engstad/BetsyBoard/README.md

# Experimental STM32L486 breakout board

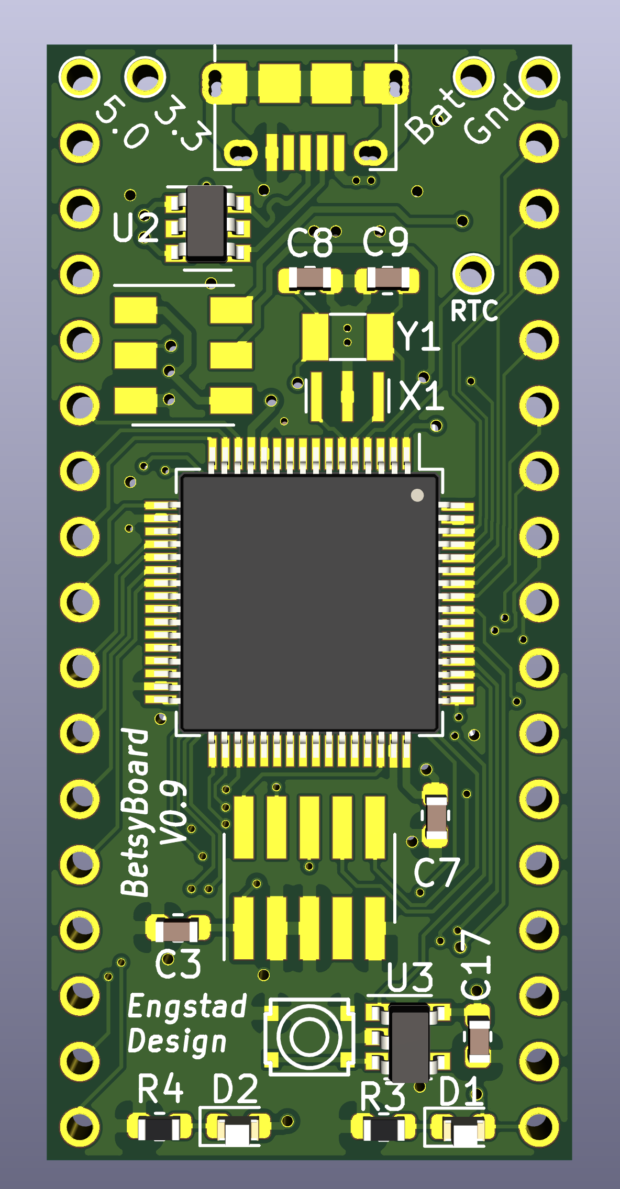
[picture p1: BetsyBoard-Front.png]
alt_tag Front of BetsyBoard

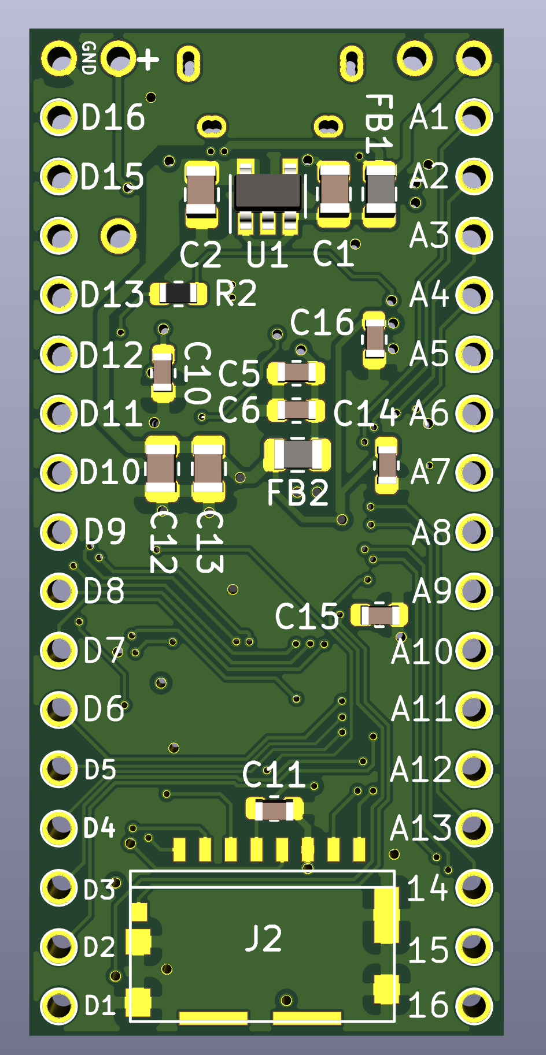
[picture p2: BetsyBoard-Back.png]
alt_tag Back of BetsyBoard
