engstad/BetsyBoard/stm32f.org

* Have about 64 pins

* 3 banks of PA, PB and PC pins (plus a single PD2), is 3*16+1 = 49 pins
* 4 pins for JTAG/DW port: PA{13,14,15}, PB3.
* SDMCC1 port: 8 pins, PC{6,7,8,9,10,11,12}.

So, 49 - 4 - 8 = 49-12 = 37. 

Teensy has 24 on top, and 17 on bottom (24+17 = 41).

So, should be in the ball-park!

FT: 5V tolerant
TT: 3V3 tolerant
_f: Fm+ capable
_l: LCD function supplied with VLCD 
_u: USB function supplied with VUSB
_a: Analog function supplied with VDDA
_s: I/O supplied only by VDDIO2  [NA]

|----+----------------+----+--------+--------+-------------------------------------------------------------------------------------------------------------------------------------------+---------------------------------------|
|  1 | VBAT           | S  |        |        |                                                                                                                                           |                                       |
|  2 | PC13           | IO | FT     | (1)(2) | EO                                                                                                                                        | RTC_TAMP1/RTC_TS/RTC_OUT/WKUP2        |
|  3 | PC14/OSC32_IN  | IO | FT     | (1)(2) | EO                                                                                                                                        | OSC32_IN                              |
|  4 | PC15/OSC32_OUT | IO | FT     | (1)(2) | EO                                                                                                                                        | OSC32_OUT                             |
|  5 | PH0/OSC_IN     | IO | FT     |        | EO                                                                                                                                        | OSC_IN                                |
|  6 | PH1/OSC_OUT    | IO | FT     |        | EO                                                                                                                                        | OSC_OUT                               |
|  7 | NRST           | IO | RST    |        |                                                                                                                                           |                                       |
|  8 | PC0            | IO | FT_fla |        | LPTIM1_IN1/I2C3_SCL/DFSDM_DATIN4/LPUART1_RX/LCD_SEG18/LPTIM2_IN1/EO                                                                       | ADC123_IN1                            |
|  9 | PC1            | IO | FT_fla |        | LPTIM1_OUT/I2C3_SDA/DFSDM_CKIN4/LPUART1_TX/LCD_SEG19/EO                                                                                   | ADC123_IN2                            |
| 10 | PC2            | IO | FT_la  |        | LPTIM1_IN2/SPI2_MISO/DFSDM_CKOUT/LCD_SEG20/EO                                                                                             | ADC123_IN3                            |
| 11 | PC3            | IO | FT_a   |        | LPTIM1_ETR/SPI2_MOSI/LCD_VLCD/SAI1_SD_A/LPTIM2_ETR/EO                                                                                     | ADC123_IN4                            |
| 12 | VSSA/VREF-     | S  |        |        |                                                                                                                                           | VREFBUF_OUT                           |
| 13 | VDDA           | S  |        |        |                                                                                                                                           |                                       |
| 14 | PA0            | IO | FT_a   |        | TIM2_CH1/TIM5_CH1/TIM8_ETR/USART2_CTS/UART4_TX/SAI1_EXTCLK/TIM2_ETR/EO                                                                    | OPAMP1_VINP/ADC12_IN5/RTC_TAMP2/WKUP1 |
| 15 | PA1            | IO | FT_la  |        | TIM2_CH2/TIM5_CH2/USART2_RTS_DE/UART4_RX/LCD_SEG0/TIM15_CH1N/EO                                                                           | OPAMP1_VINM/ADC12_IN6                 |
| 16 | PA2            | IO | FT_la  |        | TIM2_CH3/TIM5_CH3/USART2_TX/LCD_SEG1/SAI2_EXTCLK/TIM15_CH1/EO                                                                             | ADC12_IN7/WKUP4/LSCO                  |
|----+----------------+----+--------+--------+-------------------------------------------------------------------------------------------------------------------------------------------+---------------------------------------|
| 17 | PA3            | IO | TT     | (3)    | TIM2_CH4/TIM5_CH4/USART2_RX/LCD_SEG2/TIM15_CH2/EO                                                                                         | OPAMP1_VOUT/ADC12_IN8                 |
| 18 | VSS            | S  |        |        |                                                                                                                                           |                                       |
| 19 | VDD            | S  |        |        |                                                                                                                                           |                                       |
| 20 | PA4            | IO | TT_a   | (3)    | SPI1_NSS/SPI3_NSS/USART2_CK/SAI1_FS_B/LPTIM2_OUT/EO                                                                                       | ADC12_IN9/DAC1_OUT1                   |
| 21 | PA5            | IO | TT_a   | (3)    | TIM2_CH1/TIM2_ETR/TIM8_CH1N/SPI1_SCK/LPTIM2_ETR/EO                                                                                        | ADC12_IN10/DAC1_OUT2                  |
| 22 | PA6            | IO | FT_la  |        | TIM1_BKIN/TIM3_CH1/TIM8_BKIN/SPI1_MISO/USART3_CTS/QUADSPI_BK1_IO3/LCD_SEG3/TIM1_BKIN_COMP2/TIM8_BKIN_COMP2/TIM16_CH1/EO                   | OPAMP2_VINP/ADC12_IN11                |
| 23 | PA7            | IO | FT_la  |        | TIM1_CH1N/TIM3_CH2/TIM8_CH1N/SPI1_MOSI/QUADSPI_BK1_IO2/LCD_SEG4/TIM17_CH1/EO                                                              | OPAMP2_VINM/ADC12_IN12                |
| 24 | PC4            | IO | FT_la  |        | USART3_TX/LCD_SEG22/EO                                                                                                                    | COMP1_INM/ADC12_IN13                  |
| 25 | PC5            | IO | FT_la  |        | USART3_RX/LCD_SEG23/EO                                                                                                                    | COMP1_INP/ADC12_IN14/WKUP5            |
| 26 | PB0            | IO | TT_la  | (3)    | TIM1_CH2N/TIM3_CH3/TIM8_CH2N/USART3_CK/QUADSPI_BK1_IO1/LCD_SEG5/COMP1_OUT/EO                                                              | OPAMP2_VOUT/ADC12_IN15                |
| 27 | PB1            | IO | FT_la  |        | TIM1_CH3N/TIM3_CH4/TIM8_CH3N/DFSDM_DATIN0/USART3_RTS_DE/QUADSPI_BK1_IO0/LCD_SEG6/LPTIM2_IN1/EO                                            | COMP1_INM/ADC12_IN16                  |
| 28 | PB2            | IO | FT_a   |        | RTC_OUT/LPTIM1_OUT/I2C3_SMBA/DFSDM_CKIN0/EO                                                                                               | COMP1_INP                             |
| 29 | PB10           | IO | FT_fl  |        | TIM2_CH3/I2C2_SCL/SPI2_SCK/DFSDM_DATIN7/USART3_TX/LPUART1_RX/QUADSPI_CLK/LCD_SEG10/COMP1_OUT/SAI1_SCK_A/EO                                |                                       |
| 30 | PB11           | IO | FT_fl  |        | TIM2_CH4/I2C2_SDA/DFSDM_CKIN7/USART3_RX/LPUART1_TX/QUADSPI_NCS/LCD_SEG11/COMP2_OUT/EO                                                     |                                       |
| 31 | VSS            | S  |        |        |                                                                                                                                           |                                       |
| 32 | VDD            | S  |        |        |                                                                                                                                           |                                       |
|----+----------------+----+--------+--------+-------------------------------------------------------------------------------------------------------------------------------------------+---------------------------------------|
| 33 | PB12           | IO | FT_l   |        | TIM1_BKIN/TIM1_BKIN_COMP2/I2C2_SMBA/SPI2_NSS/DFSDM_DATIN1/USART3_CK/LPUART1_RTS_DE/TSC_G1_IO1/LCD_SEG12/SWPMI1_IO/SAI2_FS_A/TIM15_BKIN/EO |                                       |
| 34 | PB13           | IO | FT_fl  |        | TIM1_CH1N/I2C2_SCL/SPI2_SCK/DFSDM_CKIN1/USART3_CTS/LPUART1_CTS/TSC_G1_IO2/LCD_SEG13/SWPMI1_TX/SAI2_SCK_A/TIM15_CH1N/EO                    |                                       |
| 35 | PB14           | IO | FT_fl  |        | TIM1_CH2N/TIM8_CH2N/I2C2_SDA/SPI2_MISO/DFSDM_DATIN2/USART3_RTS_DE/TSC_G1_IO3/LCD_SEG14/SWPMI1_RX/SAI2_MCLK_A/TIM15_CH1/EO                 |                                       |
| 36 | PB15           | IO | FT_l   |        | RTC_REFIN/TIM1_CH3N/TIM8_CH3N/SPI2_MOSI/DFSDM_CKIN2/TSC_G1_IO4/LCD_SEG15/SWPMI1_SUSPEND/SAI2_SD_A/TIM15_CH2/EO                            |                                       |
| 37 | PC6            | IO | FT_l   |        | TIM3_CH1/TIM8_CH1/DFSDM_CKIN3/TSC_G4_IO1/LCD_SEG24/SDMMC1_D6/SAI2_MCLK_A/EO                                                               |                                       |
| 38 | PC7            | IO | FT_l   |        | TIM3_CH2/TIM8_CH2/DFSDM_DATIN3/TSC_G4_IO2/LCD_SEG25/SDMMC1_D7/SAI2_MCLK_B/EO                                                              |                                       |
| 39 | PC8            | IO | FT_l   |        | TIM3_CH3/TIM8_CH3/TSC_G4_IO3/LCD_SEG26/SDMMC1_D0/EO                                                                                       |                                       |
| 40 | PC9            | IO | FT_l   |        | TIM8_BKIN2/TIM3_CH4/TIM8_CH4/TSC_G4_IO4/OTG_FS_NOE/LCD_SEG27/SDMMC1_D1/SAI2_EXTCLK/TIM8_BKIN2_COMP1/EO                                    |                                       |
| 41 | PA8            | IO | FT_l   |        | MCO/TIM1_CH1/USART1_CK/OTG_FS_SOF/LCD_COM0/LPTIM2_OUT/EO                                                                                  |                                       |
| 42 | PA9            | IO | FT_lu  |        | TIM1_CH2/USART1_TX/LCD_COM1/TIM15_BKIN/EO                                                                                                 | OTG_FS_VBUS                           |
| 43 | PA10           | IO | FT_lu  |        | TIM1_CH3/USART1_RX/OTG_FS_ID/LCD_COM2/TIM17_BKIN/EO                                                                                       |                                       |
| 44 | PA11           | IO | FT_u   |        | TIM1_CH4/TIM1_BKIN2/USART1_CTS/CAN1_RX/OTG_FS_DM/TIM1_BKIN2_COMP1/EO                                                                      |                                       |
| 45 | PA12           | IO | FT_u   |        | TIM1_ETR/USART1_RTS_DE/CAN1_TX/OTG_FS_DP/EVENTOUT                                                                                         |                                       |
| 46 | PA13           | IO | FT     | (4)    | JTMS/SWDAT/IR_OUT/OTG_FS_NOE/EVENTOUT                                                                                                     |                                       |
| 47 | VSS            | S  |        |        |                                                                                                                                           |                                       |
| 48 | VDDUSB         | S  |        |        |                                                                                                                                           |                                       |
|----+----------------+----+--------+--------+-------------------------------------------------------------------------------------------------------------------------------------------+---------------------------------------|
| 49 | PA14           | IO | FT     | (4)    | JTCK/SWCLK/EVENTOUT                                                                                                                       |                                       |
| 50 | PA15           | IO | FT_l   | (4)    | JTDI/TIM2_CH1/TIM2_ETR/SPI1_NSS/SPI3_NSS/UART4_RTS_DE/TSC_G3_IO1/LCD_SEG17/SAI2_FS_B/EVENTOUT                                             |                                       |
| 51 | PC10           | IO | FT_l   |        | SPI3_SCK/USART3_TX/UART4_TX/TSC_G3_IO2/LCD_COM4/LCD_SEG28/LCD_SEG40/SDMMC1_D2/SAI2_SCK_B/EVENTOUT                                         |                                       |
| 52 | PC11           | IO | FT_l   |        | SPI3_MISO/USART3_RX/UART4_RX/TSC_G3_IO3/LCD_COM5/LCD_SEG29/LCD_SEG41/SDMMC1_D3/SAI2_MCLK_B/EVENTOUT                                       |                                       |
| 53 | PC12           | IO | FT_l   |        | SPI3_MOSI/USART3_CK/UART5_TX/TSC_G3_IO4/LCD_COM6/LCD_SEG30/LCD_SEG42/SDMMC1_CK/SAI2_SD_B/EVENTOUT                                         |                                       |
| 54 | PD2            | IO | FT_l   |        | TIM3_ETR/USART3_RTS_DE/UART5_RX/TSC_SYNC/LCD_COM7/LCD_SEG31/LCD_SEG43/SDMMC1_CMD/EVENTOUT                                                 |                                       |
| 55 | PB3            | IO | FT_la  | (4)    | JTDO/TRACESWO/TIM2_CH2/SPI1_SCK/SPI3_SCK/USART1_RTS_DE/LCD_SEG7/SAI1_SCK_B/EVENTOUT                                                       | COMP2_INM                             |
| 56 | PB4            | IO | FT_la  | (4)    | NJTRST/TIM3_CH1/SPI1_MISO/SPI3_MISO/USART1_CTS/UART5_RTS_DE/TSC_G2_IO1/LCD_SEG8/SAI1_MCLK_B/TIM17_BKIN/EVENTOUT                           | COMP2_INP                             |
| 57 | PB5            | IO | FT_la  |        | LPTIM1_IN1/TIM3_CH2/I2C1_SMBA/SPI1_MOSI/SPI3_MOSI/USART1_CK/UART5_CTS/TSC_G2_IO2/LCD_SEG9/COMP2_OUT/SAI1_SD_B/TIM16_BKIN/EVENTOUT         |                                       |
| 58 | PB6            | IO | FT_fa  |        | LPTIM1_ETR/TIM4_CH1/TIM8_BKIN2/I2C1_SCL/DFSDM_DATIN5/USART1_TX/TSC_G2_IO3/TIM8_BKIN2_COMP2/SAI1_FS_B/TIM16_CH1N/EVENTOUT                  | COMP2_INP                             |
| 59 | PB7            | IO | FT_fla |        | LPTIM1_IN2/TIM4_CH2/TIM8_BKIN/I2C1_SDA/DFSDM_CKIN5/USART1_RX/UART4_CTS/TSC_G2_IO4/LCD_SEG21/FMC_NL/TIM8_BKIN_COMP1/TIM17_CH1N/EVENTOUT    | COMP2_INM/PVD_IN                      |
| 60 | BOOT0          | B  |        |        |                                                                                                                                           |                                       |
| 61 | PB8            | IO | FT_fl  |        | TIM4_CH3/I2C1_SCL/DFSDM_DATIN6/CAN1_RX/LCD_SEG16/SDMMC1_D4/SAI1_MCLK_A/TIM16_CH1/EVENTOUT                                                 |                                       |
| 62 | PB9            | IO | FT_fl  |        | IR_OUT/TIM4_CH4/I2C1_SDA/SPI2_NSS/DFSDM_CKIN6/CAN1_TX/LCD_COM3/SDMMC1_D5/SAI1_FS_A/TIM17_CH1/EVENTOUT                                     |                                       |
| 63 | VSS            | S  |        |        |                                                                                                                                           |                                       |
| 64 | VDD            | S  |        |        |                                                                                                                                           |                                       |
|----+----------------+----+--------+--------+-------------------------------------------------------------------------------------------------------------------------------------------+---------------------------------------|

(1): Supplied through power switch [GPIO is limited]
(2): 
(3): Reduced touch sensing sensitivity
(4): JTAG ready after reset (PA15,PA13,PB4 pulled up, PA14 pulled down)
