engstad/BetsyBoard/BetsyBoardBig-schematic.pdf

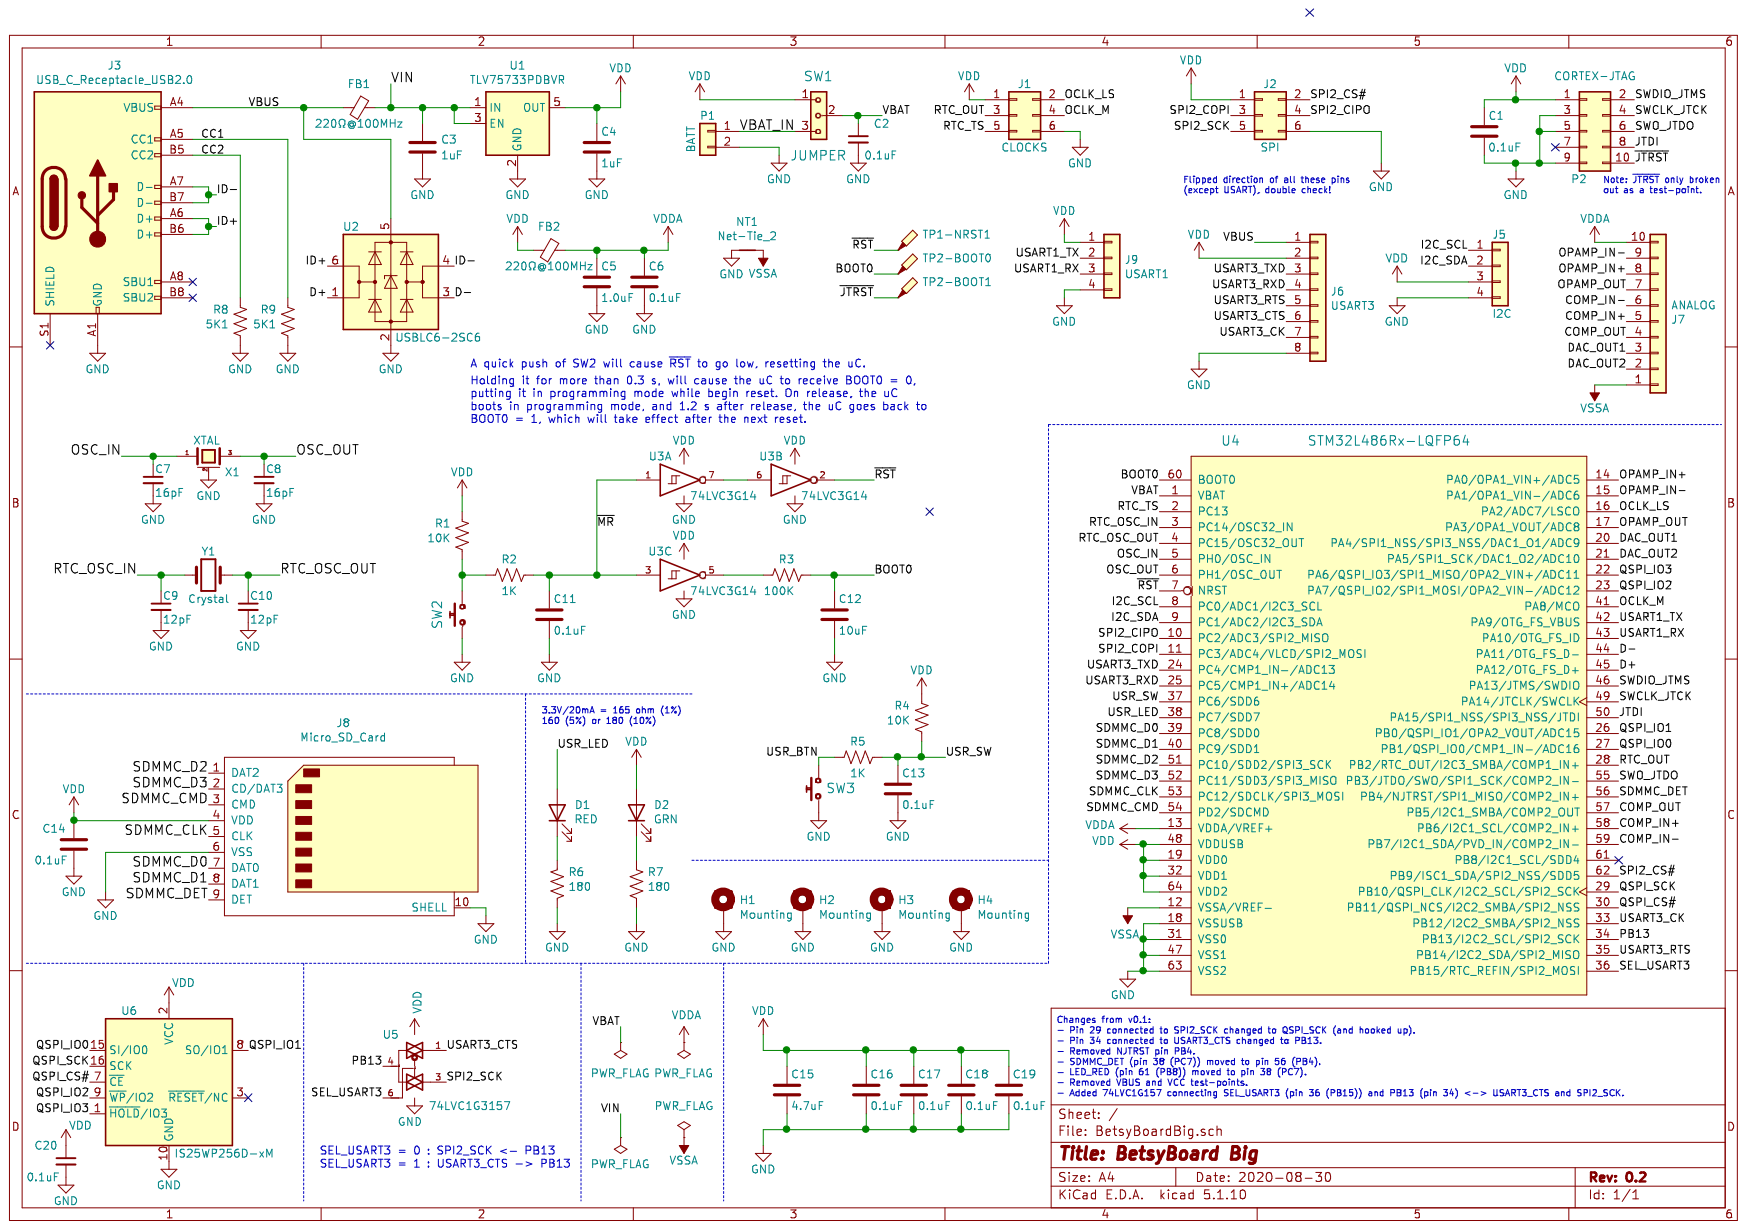
[picture p3: page 1]
