engstad/BetsyBoard/BetsyBoard-Front.pdf

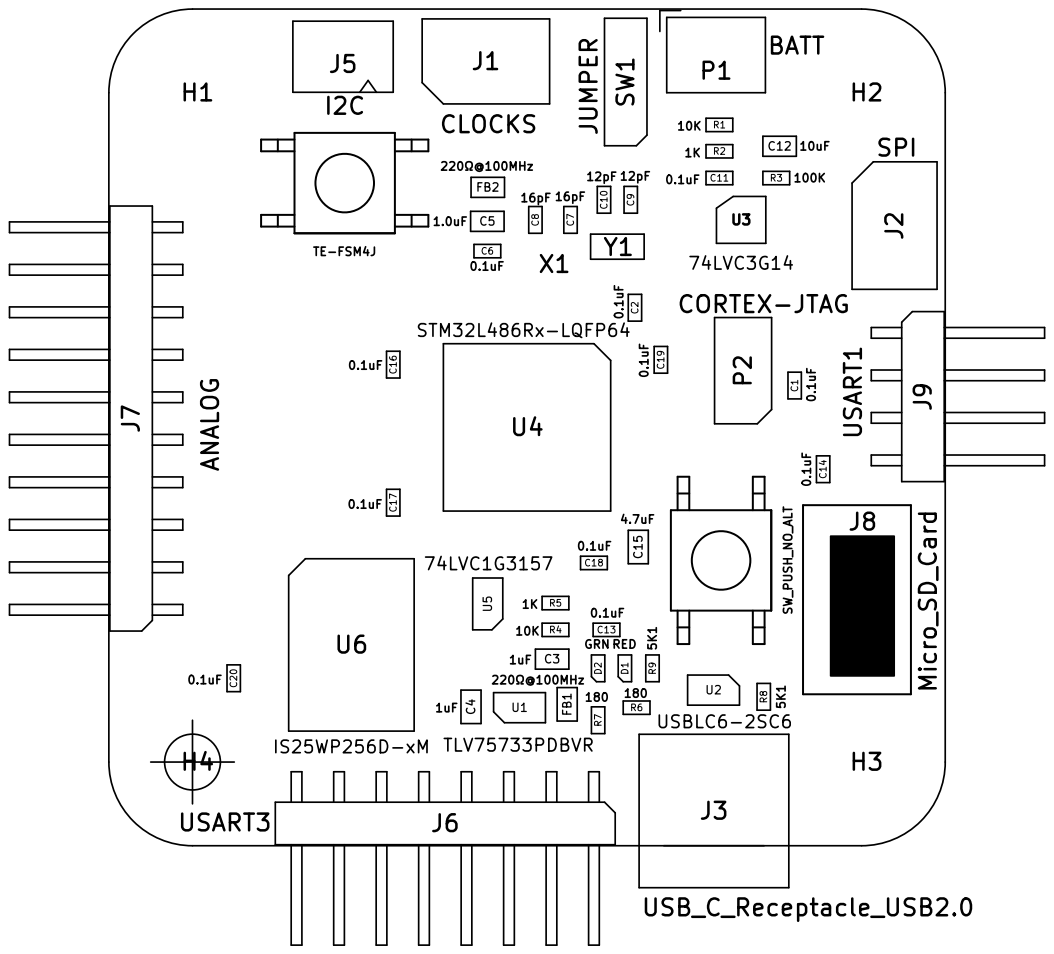
[picture p4: page 1]
