engstad/BetsyBoard/BetsyBoardBig.kicad_pcb

## KiCad design BetsyBoardBig.kicad_pcb (2024-01-12)

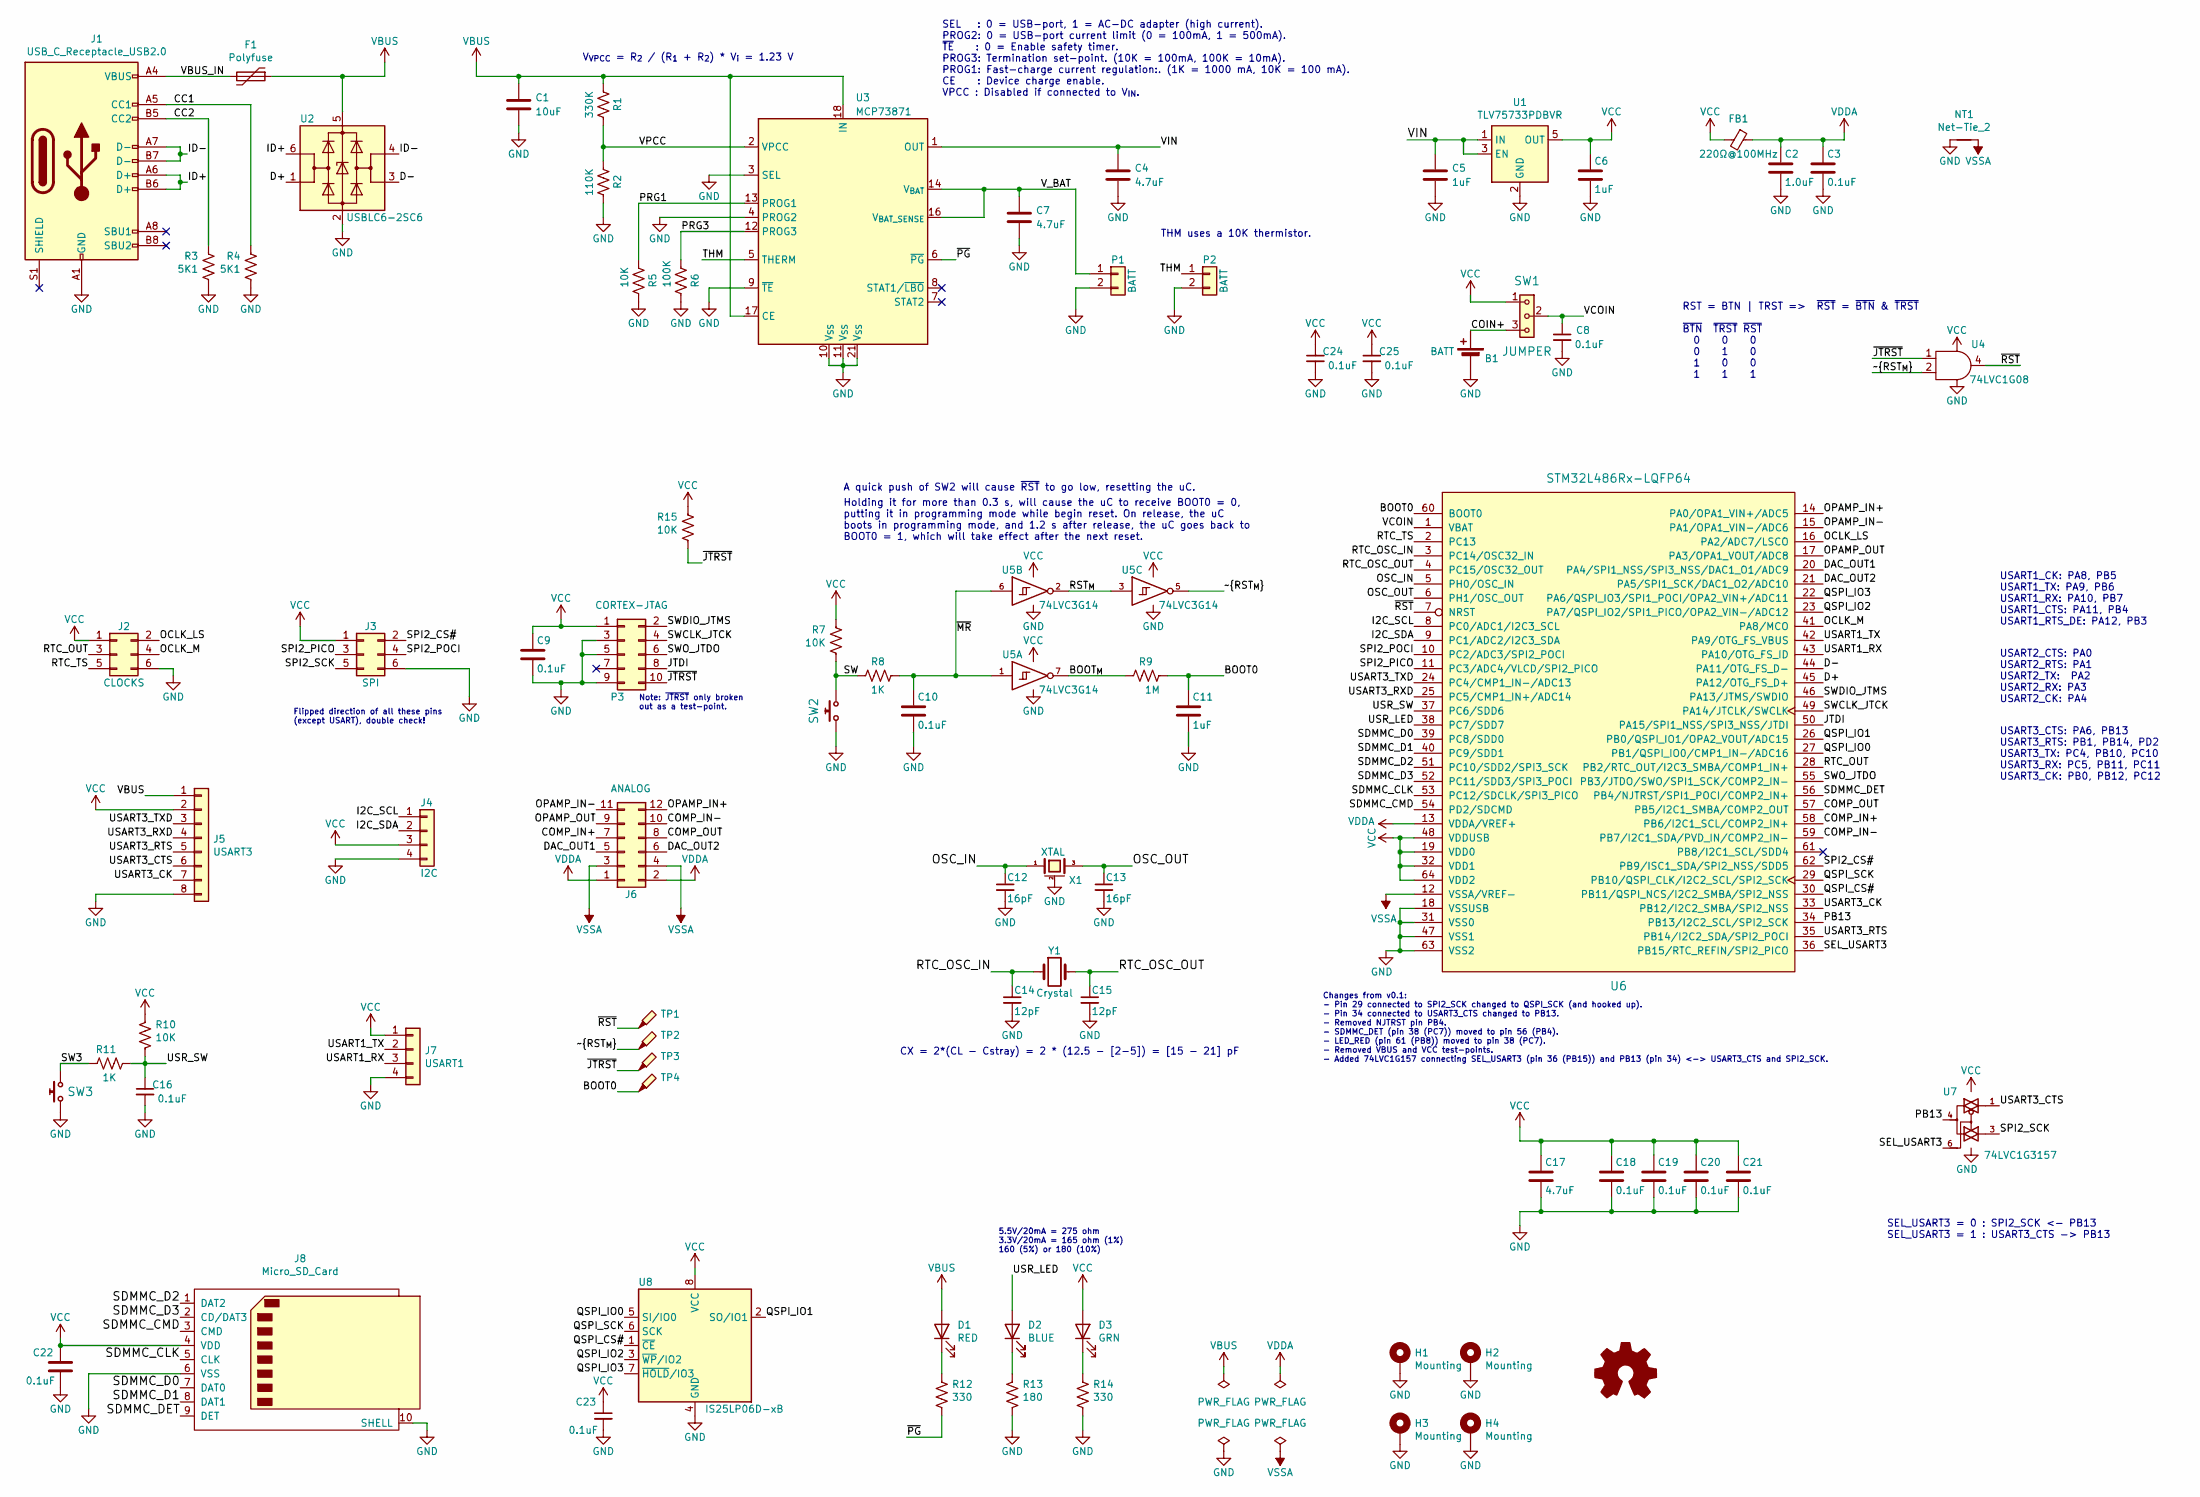
[picture p5: schematic BetsyBoardBig.kicad_sch, BetsyBoard Big]

Parts:
B1: BATT; Battery_Keystone_2894
C1: 10uF; C_0805_2012Metric
C2: 1.0uF; C_0805_2012Metric
C3, C8, C9, C10, C16, C18, C19, C20, C21, C22, C23, C24, C25: 0.1uF; C_0603_1608Metric
C4, C7, C17: 4.7uF; C_0805_2012Metric
C5, C6: 1uF; C_0805_2012Metric
C11: 1uF; C_0603_1608Metric
C12, C13: 16pF; C_0603_1608Metric
C14, C15: 12pF; C_0603_1608Metric
D1: RED; LED_0603_1608Metric
D2: BLUE; LED_0603_1608Metric
D3: GRN; LED_0603_1608Metric
F1: Polyfuse; Fuse_0805_2012Metric
FB1: 220Ω@100MHz; L_0805_2012Metric; Manuf # BLM21PG221SN1D
H1, H2, H3, H4: Mounting; MountingHole_3.2mm_M3_Pad_Via
J1: USB_C_Receptacle_USB2.0; USB_C_Receptacle_GCT_USB4085
J2: CLOCKS; PinHeader_2x03_P2.54mm_Vertical
J3: SPI; PinHeader_2x03_P2.54mm_Vertical
J4: I2C; JST_SH_SM04B-SRSS-TB_1x04-1MP_P1.00mm_Horizontal
J5: USART3; PinHeader_1x08_P2.54mm_Horizontal
J6: ANALOG; PinHeader_2x06_P2.54mm_Horizontal
J7: USART1; PinHeader_1x04_P2.54mm_Horizontal
J8: Micro_SD_Card; Molex_PS_105162_001; DigiKey# WM14405CT-ND
NT1: Net-Tie_2; NetTie-2_SMD_Pad0.5mm
P1: BATT; JST_PH_B2B-PH-K_1x02_P2.00mm_Vertical
P2: BATT; pin-socket-2
P3: CORTEX-JTAG; PinHeader_2x05_P1.27mm_Vertical
R1: 330K; R_0603_1608Metric
R2: 110K; R_0603_1608Metric
R3, R4: 5K1; R_0603_1608Metric
R5, R7, R10, R15: 10K; R_0603_1608Metric
R6: 100K; R_0603_1608Metric
R8, R11: 1K; R_0603_1608Metric
R9: 1M; R_0603_1608Metric
R12, R14: 330; R_0603_1608Metric
R13: 180; R_0603_1608Metric
SW1: JUMPER; PinHeader_1x03_P2.54mm_Vertical
SW2: TE-FSM4J; TACTILE_SWITCH-TE-FSM4JSMAATR
SW3: SW_PUSH_NO_ALT; TACTILE_SWITCH-TE-FSM4JSMAATR
TP1, TP2, TP3, TP4: TestPoint_Probe; TestPoint_Pad_1.0x1.0mm
U1: TLV75733PDBVR‎; SOT-23-5
U2: USBLC6-2SC6; SOT-23-6
U3: MCP73871; QFN-20-1EP_4x4mm_P0.5mm_EP2.5x2.5mm
U4: 74LVC1G08; SOT-23-5
U5: 74LVC3G14; SSOP-8_2.95x2.8mm_P0.65mm
U6: STM32L486Rx-LQFP64; LQFP-64_10x10mm_P0.5mm
U7: 74LVC1G3157; SOT-23-6
U8: IS25LP06D-xB; SOIC-8_5.275x5.275mm_P1.27mm
X1: XTAL; cstce-v-c
Y1: Crystal; Crystal_SMD_3215-2Pin_3.2x1.5mm

Connections:
/BOOT0: C11.1, R9.1, TP4.1, U6.60 (BOOT0)
/BOOT_{M}: R9.2, U5.7
/CC1: J1.A5 (CC1), R4.1
/CC2: J1.B5 (CC2), R3.1
/COIN+: B1.1 (+), SW1.3
/COMP_IN+: J6.7, U6.58 (PB6/I2C1_SCL/COMP2_IN+)
/COMP_IN-: J6.10, U6.59 (PB7/I2C1_SDA/PVD_IN/COMP2_IN-)
/COMP_OUT: J6.8, U6.57 (PB5/I2C1_SMBA/COMP2_OUT)
/D+: U2.1 (I/O1), U6.45 (PA12/OTG_FS_D+)
/D-: U2.3 (I/O2), U6.44 (PA11/OTG_FS_D-)
/DAC_OUT1: J6.5, U6.20 (PA4/SPI1_NSS/SPI3_NSS/DAC1_O1/ADC9)
/DAC_OUT2: J6.6, U6.21 (PA5/SPI1_SCK/DAC1_O2/ADC10)
/I2C_SCL: J4.1, U6.8 (PC0/ADC1/I2C3_SCL)
/I2C_SDA: J4.2, U6.9 (PC1/ADC2/I2C3_SDA)
/ID+: J1.A6 (D+), J1.B6 (D+), U2.6 (I/O1)
/ID-: J1.A7 (D-), J1.B7 (D-), U2.4 (I/O2)
/JTDI: P3.8, U6.50 (PA15/SPI1_NSS/SPI3_NSS/JTDI)
/OCLK_LS: J2.2, U6.16 (PA2/ADC7/LSCO)
/OCLK_M: J2.4, U6.41 (PA8/MCO)
/OPAMP_IN+: J6.12, U6.14 (PA0/OPA1_VIN+/ADC5)
/OPAMP_IN-: J6.11, U6.15 (PA1/OPA1_VIN-/ADC6)
/OPAMP_OUT: J6.9, U6.17 (PA3/OPA1_VOUT/ADC8)
/OSC_IN: C12.1, U6.5 (PH0/OSC_IN), X1.1
/OSC_OUT: C13.1, U6.6 (PH1/OSC_OUT), X1.3
/PB13: U6.34 (PB13/I2C2_SCL/SPI2_SCK), U7.4
/PRG1: R5.2, U3.13 (PROG1)
/PRG3: R6.2, U3.12 (PROG3)
/QSPI_CS#: U6.30 (PB11/QSPI_NCS/I2C2_SMBA/SPI2_NSS), U8.1 (~CE)
/QSPI_IO0: U6.27 (PB1/QSPI_IO0/CMP1_IN-/ADC16), U8.5 (SI/IO0)
/QSPI_IO1: U6.26 (PB0/QSPI_IO1/OPA2_VOUT/ADC15), U8.2 (SO/IO1)
/QSPI_IO2: U6.23 (PA7/QSPI_IO2/SPI1_PICO/OPA2_VIN-/ADC12), U8.3 (~WP/IO2)
/QSPI_IO3: U6.22 (PA6/QSPI_IO3/SPI1_POCI/OPA2_VIN+/ADC11), U8.7 (~HOLD/IO3)
/QSPI_SCK: U6.29 (PB10/QSPI_CLK/I2C2_SCL/SPI2_SCK), U8.6 (SCK)
/RST_{M}: U5.2, U5.3
/RTC_OSC_IN: C14.1, U6.3 (PC14/OSC32_IN), Y1.1
/RTC_OSC_OUT: C15.1, U6.4 (PC15/OSC32_OUT), Y1.2
/RTC_OUT: J2.3, U6.28 (PB2/RTC_OUT/I2C3_SMBA/COMP1_IN+)
/RTC_TS: J2.5, U6.2 (PC13)
/SDMMC_CLK: J8.5 (CLK), U6.53 (PC12/SDCLK/SPI3_PICO)
/SDMMC_CMD: J8.3 (CMD), U6.54 (PD2/SDCMD)
/SDMMC_D0: J8.7 (DAT0), U6.39 (PC8/SDD0)
/SDMMC_D1: J8.8 (DAT1), U6.40 (PC9/SDD1)
/SDMMC_D2: J8.1 (DAT2), U6.51 (PC10/SDD2/SPI3_SCK)
/SDMMC_D3: J8.2 (CD/DAT3), U6.52 (PC11/SDD3/SPI3_POCI)
/SDMMC_DET: J8.9 (DET), U6.56 (PB4/NJTRST/SPI1_POCI/COMP2_IN+)
/SEL_USART3: U6.36 (PB15/RTC_REFIN/SPI2_PICO), U7.6
/SPI2_CS#: J3.2, U6.62 (PB9/ISC1_SDA/SPI2_NSS/SDD5)
/SPI2_PICO: J3.3, U6.11 (PC3/ADC4/VLCD/SPI2_PICO)
/SPI2_POCI: J3.4, U6.10 (PC2/ADC3/SPI2_POCI)
/SPI2_SCK: J3.5, U7.3
/SW: R7.2, R8.2, SW2.2
/SW3: R11.2, SW3.2
/SWCLK_JTCK: P3.4, U6.49 (PA14/JTCLK/SWCLK)
/SWDIO_JTMS: P3.2, U6.46 (PA13/JTMS/SWDIO)
/SWO_JTDO: P3.6, U6.55 (PB3/JTDO/SWO/SPI1_SCK/COMP2_IN-)
/THM: P2.1, U3.5 (THERM)
/USART1_RX: J7.3, U6.43 (PA10/OTG_FS_ID)
/USART1_TX: J7.2, U6.42 (PA9/OTG_FS_VBUS)
/USART3_CK: J5.7, U6.33 (PB12/I2C2_SMBA/SPI2_NSS)
/USART3_CTS: J5.6, U7.1
/USART3_RTS: J5.5, U6.35 (PB14/I2C2_SDA/SPI2_POCI)
/USART3_RXD: J5.4, U6.25 (PC5/CMP1_IN+/ADC14)
/USART3_TXD: J5.3, U6.24 (PC4/CMP1_IN-/ADC13)
/USR_LED: D2.2 (A), U6.38 (PC7/SDD7)
/USR_SW: C16.1, R10.2, R11.1, U6.37 (PC6/SDD6)
/VBUS_IN: F1.2, J1.A4 (VBUS), J1.A9 (VBUS), J1.B4 (VBUS), J1.B9 (VBUS)
/VCOIN: C8.1, SW1.2, U6.1 (VBAT)
/VIN: C4.1, C5.1, U1.1 (IN), U1.3 (EN), U3.1 (OUT), U3.20 (OUT)
/VPCC: R1.1, R2.2, U3.2 (VPCC)
/V_BAT: C7.1, P1.1, U3.14 (V_{BAT}), U3.15 (V_{BAT}), U3.16 (V_{BAT_SENSE})
/~JTRST: P3.10, R15.2, TP3.1, U4.1
/~MR: C10.1, R8.1, U5.1, U5.6
/~PG: R12.2, U3.6 (~PG)
/~RST_{M}: TP2.1, U4.2, U5.5
/~RST: TP1.1, U4.4, U6.7 (NRST)
GND: B1.2 (-), C1.2, C2.2, C3.2, C4.2, C5.2, C6.2, C7.2, C8.2, C9.2, C10.2, C11.2, C12.2, C13.2, C14.2, C15.2, C16.2, C17.2, C18.2, C19.2, C20.2, C21.2, C22.2, C23.2, C24.2, C25.2, H1.1, H2.1, H3.1, H4.1, J1.A1 (GND), J1.A12 (GND), J1.B1 (GND), J1.B12 (GND), J2.6, J3.6, J4.4, J5.8, J7.4, J8.6 (VSS), J8.10 (SHELL), NT1.1, P1.2, P2.2, P3.3, P3.5, P3.9, R2.1, R3.2, R4.2, R5.1, R6.1, R13.2, R14.2, SW2.1, SW3.1, U1.2 (GND), U2.2 (GND), U3.3 (SEL), U3.4 (PROG2), U3.9 (~TE), U3.10 (V_{SS}), U3.11 (V_{SS}), U3.21 (V_{SS}), U4.3 (GND), U5.4 (GND), U6.18 (VSSUSB), U6.31 (VSS0), U6.47 (VSS1), U6.63 (VSS2), U7.2 (GND), U8.4 (GND), X1.2 (gnd)
unnamed: D1.1 (K), R12.1
unnamed: D2.1 (K), R13.1
unnamed: D3.1 (K), R14.1
VBUS: C1.1, D1.2 (A), F1.1, J5.1, R1.2, U2.5 (VBUS), U3.17 (CE), U3.18 (IN), U3.19 (IN)
VCC: C6.1, C9.1, C17.1, C18.1, C19.1, C20.1, C21.1, C22.1, C23.1, C24.1, C25.1, D3.2 (A), FB1.2, J2.1, J3.1, J4.3, J5.2, J7.1, J8.4 (VDD), P3.1, R7.1, R10.1, R15.1, SW1.1, U1.5 (OUT), U4.5 (VCC), U5.8 (VCC), U6.19 (VDD0), U6.32 (VDD1), U6.48 (VDDUSB), U6.64 (VDD2), U7.5 (VCC), U8.8 (VCC)
VDDA: C2.1, C3.1, FB1.1, J6.1, J6.2, U6.13 (VDDA/VREF+)
VSSA: J6.3, J6.4, NT1.2, U6.12 (VSSA/VREF-)

Notes on the sheet:
A quick push of SW2 will cause ~{RST} to go low, resetting the uC.
Note: ~{JTRST} only broken out as a test-point.
RST = BTN | TRST => ~{RST} = ~{BTN} & ~{TRST} ~{BTN} ~{TRST} ~{RST} 0 0 0 0 1 0 1 0 0 1 1 1
USART2_CTS: PA0 USART2_RTS: PA1 USART2_TX: PA2 USART2_RX: PA3 USART2_CK: PA4
Holding it for more than 0.3 s, will cause the uC to receive BOOT0 = 0, putting it in programming mode while begin reset. On release, the uC boots in programming mode, and 1.2 s after release, the uC goes back to BOOT0 = 1, which will take effect after the next reset.
Flipped direction of all these pins (except USART), double check!
THM uses a 10K thermistor.
CX = 2*(CL - Cstray) = 2 * (12.5 - [2-5]) = [15 - 21] pF
V_{VPCC} = R_{2} / (R_{1} + R_{2}) * V_{i} = 1.23 V
USART1_CK: PA8, PB5 USART1_TX: PA9, PB6 USART1_RX: PA10, PB7 USART1_CTS: PA11, PB4 USART1_RTS_DE: PA12, PB3
USART3_CTS: PA6, PB13 USART3_RTS: PB1, PB14, PD2 USART3_TX: PC4, PB10, PC10 USART3_RX: PC5, PB11, PC11 USART3_CK: PB0, PB12, PC12
SEL_USART3 = 0 : SPI2_SCK <- PB13 SEL_USART3 = 1 : USART3_CTS -> PB13
SEL : 0 = USB-port, 1 = AC-DC adapter (high current). PROG2: 0 = USB-port current limit (0 = 100mA, 1 = 500mA). ~{TE} : 0 = Enable safety timer. PROG3: Termination set-point. (10K = 100mA, 100K = 10mA). PROG1: Fast-charge current regulation:. (1K = 1000 mA, 10K = 100 mA). CE : Device charge enable.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
5.5V/20mA = 275 ohm 3.3V/20mA = 165 ohm (1%) 160 (5%) or 180 (10%)
Changes from v0.1: - Pin 29 connected to SPI2_SCK changed to QSPI_SCK (and hooked up). - Pin 34 connected to USART3_CTS changed to PB13. - Removed NJTRST pin PB4. - SDMMC_DET (pin 38 (PC7)) moved to pin 56 (PB4). - LED_RED (pin 61 (PB8)) moved to pin 38 (PC7). - Removed VBUS and VCC test-points. - 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

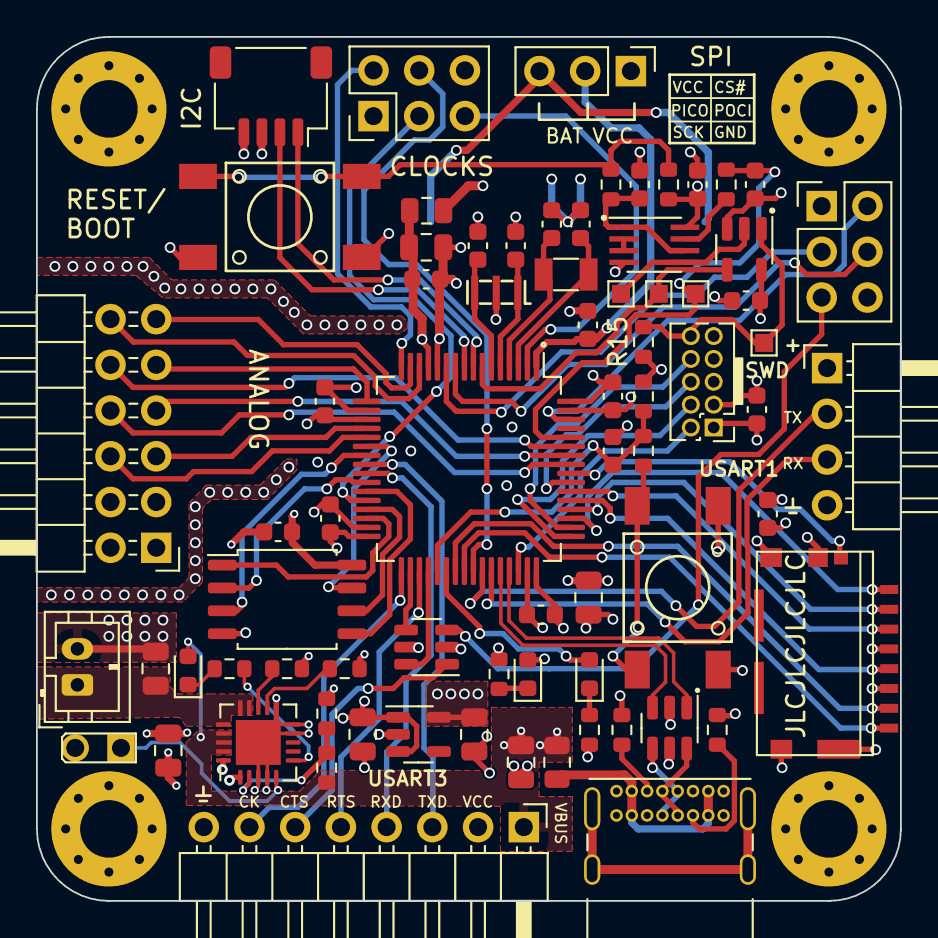
[picture p6: board BetsyBoardBig.kicad_pcb from above]

Board: 4 copper layers, 48.0 x 48.0 mm, 79 parts (1 on the bottom side), 83 nets.
