engstad/BetsyBoard/BetsyBoard.kicad_pcb

## KiCad design BetsyBoard.kicad_pcb (2024-01-05)

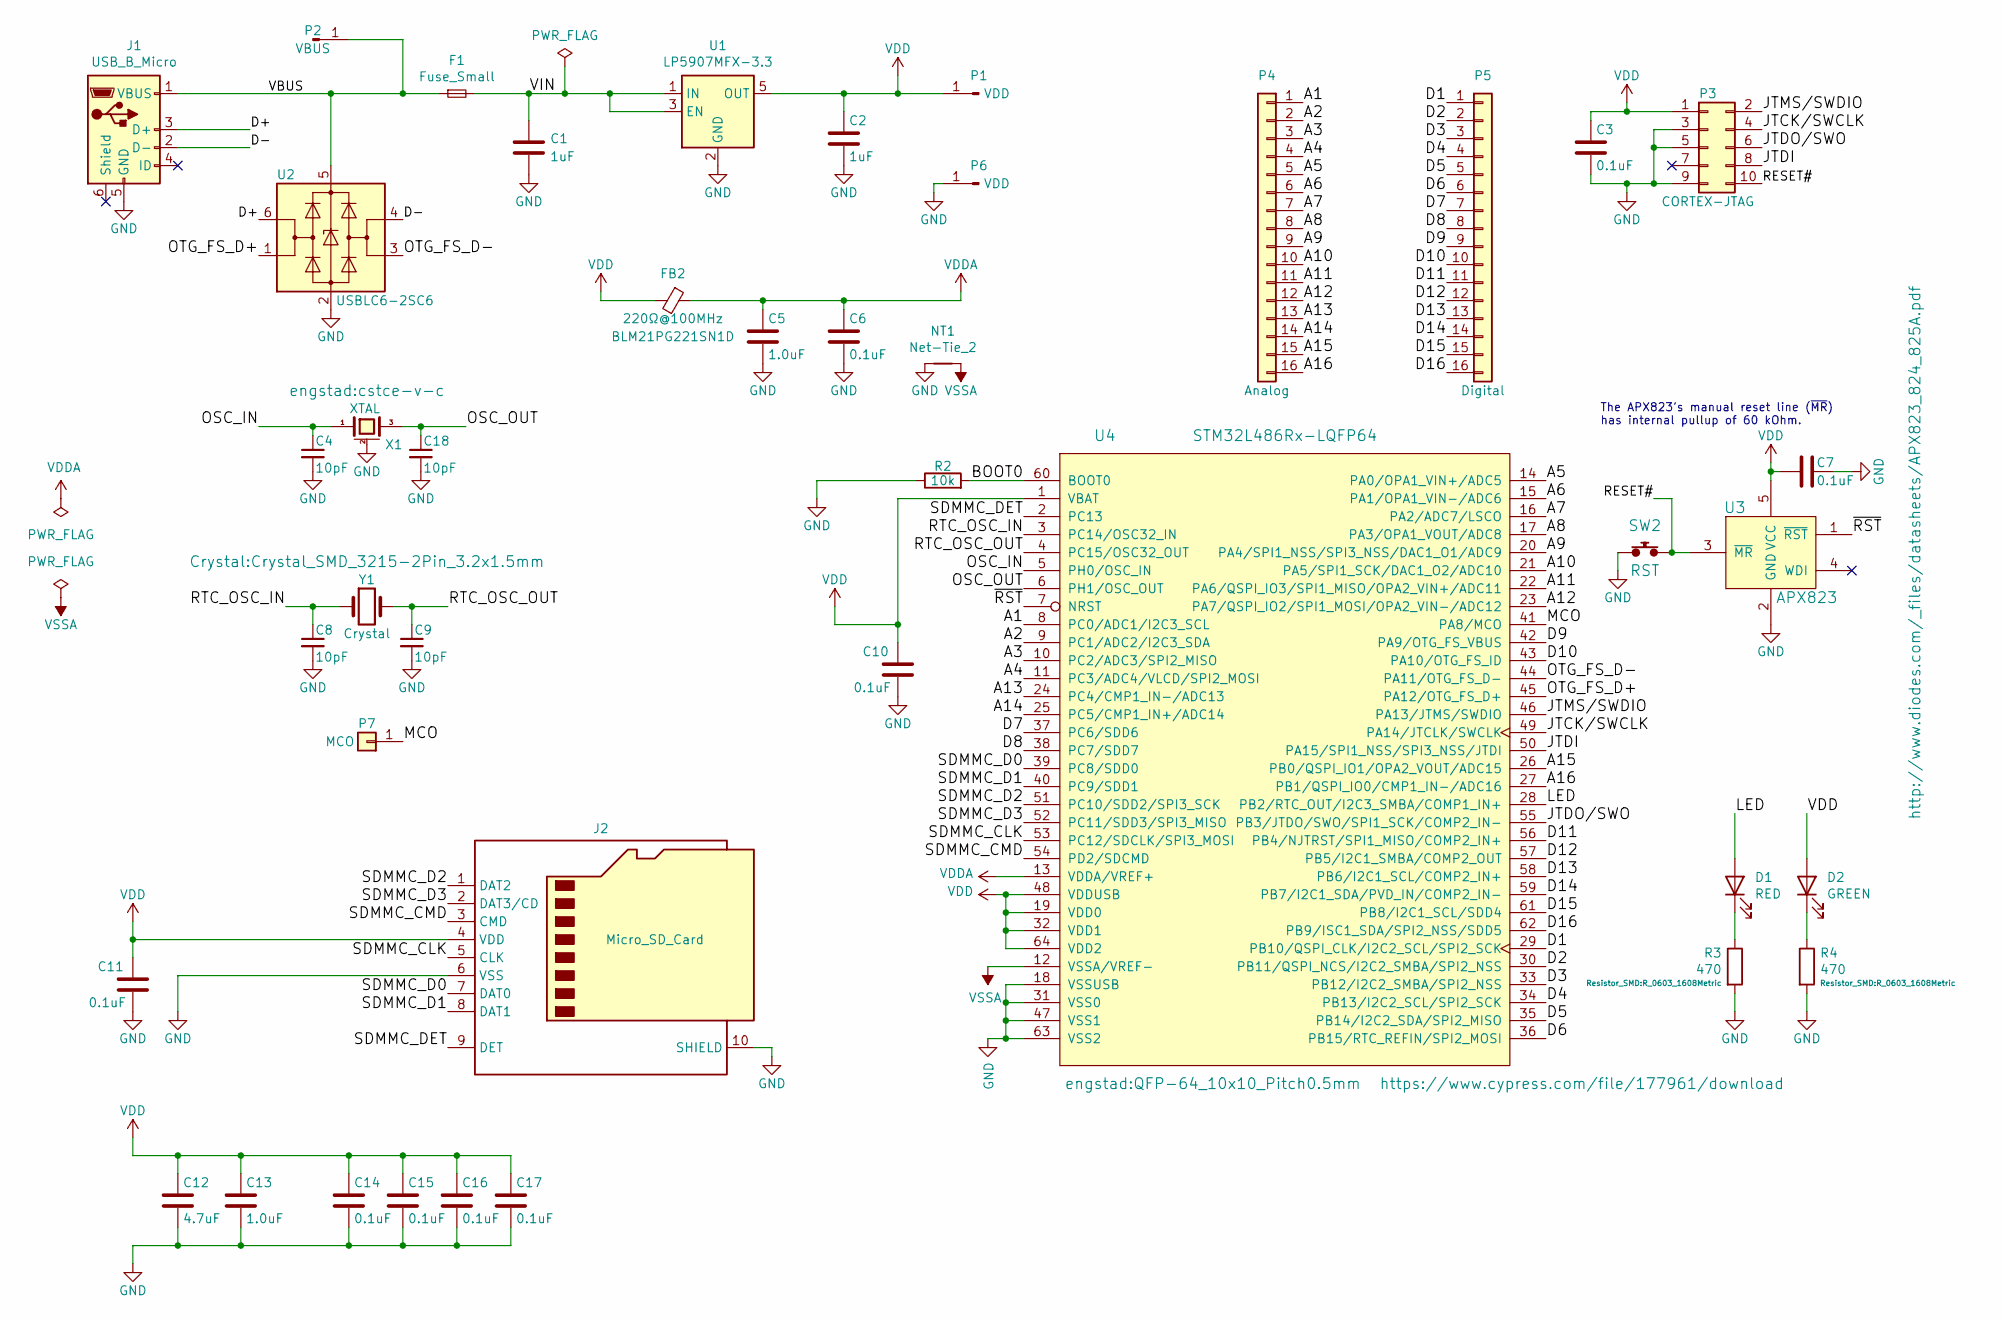
[picture p7: schematic BetsyBoard.kicad_sch]

Parts:
C1, C2: 1uF; C_0805_2012Metric
C3, C6, C7, C10, C11, C14, C15, C16, C17: 0.1uF; C_0603_1608Metric
C4, C8, C9, C18: 10pF; C_0603_1608Metric
C5: 1.0uF; C_0603_1608Metric
C12: 4.7uF; C_0805_2012Metric
C13: 1.0uF; C_0805_2012Metric
D1: RED; LED_0603_1608Metric
D2: GREEN; LED_0603_1608Metric
F1: Fuse_Small; Fuse_0805_2012Metric
FB2: 220Ω@100MHz; L_0805_2012Metric; Manuf # BLM21PG221SN1D
J1: USB_B_Micro; usb-micro-b-amphenol-fci-10118194-oval
J2: Micro_SD_Card; Molex_PS_105162_001
NT1: Net-Tie_2; net-tie-0.4mm
P1: VDD; pin-strip-1
P2: VBUS; pin-strip-1
P3: CORTEX-JTAG; conn-jtag-0.05; Mouser# 200-FTSH10501LDV007K
P4: Analog; pin-strip-16
P5: Digital; pin-strip-16
P6: VDD; PinHeader_1x01_P2.54mm_Vertical
P7: MCO; pin-socket-1
R2: 10k; R_0603_1608Metric
R3, R4: 470; R_0603_1608Metric
SW2: RST; tactile-switch-evpay-34x29mm
U1: LP5907MFX-3.3; SOT-23-5
U2: USBLC6-2SC6; SOT-23-6
U3: APX823; SOT-23-5
U4: STM32L486Rx-LQFP64; QFP-64_10x10_Pitch0.5mm
X1: XTAL; cstce-v-c
Y1: Crystal; Crystal_SMD_3215-2Pin_3.2x1.5mm

Connections:
/A1: P4.1, U4.8 (PC0/ADC1/I2C3_SCL)
/A2: P4.2, U4.9 (PC1/ADC2/I2C3_SDA)
/A3: P4.3, U4.10 (PC2/ADC3/SPI2_MISO)
/A4: P4.4, U4.11 (PC3/ADC4/VLCD/SPI2_MOSI)
/A5: P4.5, U4.14 (PA0/OPA1_VIN+/ADC5)
/A6: P4.6, U4.15 (PA1/OPA1_VIN-/ADC6)
/A7: P4.7, U4.16 (PA2/ADC7/LSCO)
/A8: P4.8, U4.17 (PA3/OPA1_VOUT/ADC8)
/A9: P4.9, U4.20 (PA4/SPI1_NSS/SPI3_NSS/DAC1_O1/ADC9)
/A10: P4.10, U4.21 (PA5/SPI1_SCK/DAC1_O2/ADC10)
/A11: P4.11, U4.22 (PA6/QSPI_IO3/SPI1_MISO/OPA2_VIN+/ADC11)
/A12: P4.12, U4.23 (PA7/QSPI_IO2/SPI1_MOSI/OPA2_VIN-/ADC12)
/A13: P4.13, U4.24 (PC4/CMP1_IN-/ADC13)
/A14: P4.14, U4.25 (PC5/CMP1_IN+/ADC14)
/A15: P4.15, U4.26 (PB0/QSPI_IO1/OPA2_VOUT/ADC15)
/A16: P4.16, U4.27 (PB1/QSPI_IO0/CMP1_IN-/ADC16)
/BOOT0: R2.2, U4.60 (BOOT0)
/D1: P5.1, U4.29 (PB10/QSPI_CLK/I2C2_SCL/SPI2_SCK)
/D2: P5.2, U4.30 (PB11/QSPI_NCS/I2C2_SMBA/SPI2_NSS)
/D3: P5.3, U4.33 (PB12/I2C2_SMBA/SPI2_NSS)
/D4: P5.4, U4.34 (PB13/I2C2_SCL/SPI2_SCK)
/D5: P5.5, U4.35 (PB14/I2C2_SDA/SPI2_MISO)
/D6: P5.6, U4.36 (PB15/RTC_REFIN/SPI2_MOSI)
/D7: P5.7, U4.37 (PC6/SDD6)
/D8: P5.8, U4.38 (PC7/SDD7)
/D9: P5.9, U4.42 (PA9/OTG_FS_VBUS)
/D10: P5.10, U4.43 (PA10/OTG_FS_ID)
/D11: P5.11, U4.56 (PB4/NJTRST/SPI1_MISO/COMP2_IN+)
/D12: P5.12, U4.57 (PB5/I2C1_SMBA/COMP2_OUT)
/D13: P5.13, U4.58 (PB6/I2C1_SCL/COMP2_IN+)
/D14: P5.14, U4.59 (PB7/I2C1_SDA/PVD_IN/COMP2_IN-)
/D15: P5.15, U4.61 (PB8/I2C1_SCL/SDD4)
/D16: P5.16, U4.62 (PB9/ISC1_SDA/SPI2_NSS/SDD5)
/D+: J1.3 (D+), U2.6 (I/O1)
/D-: J1.2 (D-), U2.4 (I/O2)
/JTCK/SWCLK: P3.4, U4.49 (PA14/JTCLK/SWCLK)
/JTDI: P3.8, U4.50 (PA15/SPI1_NSS/SPI3_NSS/JTDI)
/JTDO/SWO: P3.6, U4.55 (PB3/JTDO/SWO/SPI1_SCK/COMP2_IN-)
/JTMS/SWDIO: P3.2, U4.46 (PA13/JTMS/SWDIO)
/LED: D1.2 (A), U4.28 (PB2/RTC_OUT/I2C3_SMBA/COMP1_IN+)
/MCO: P7.1, U4.41 (PA8/MCO)
/OSC_IN: C4.1, U4.5 (PH0/OSC_IN), X1.1
/OSC_OUT: C18.1, U4.6 (PH1/OSC_OUT), X1.3
/OTG_FS_D+: U2.1 (I/O1), U4.45 (PA12/OTG_FS_D+)
/OTG_FS_D-: U2.3 (I/O2), U4.44 (PA11/OTG_FS_D-)
/RESET#: P3.10, SW2.2, U3.3 (~MR)
/RTC_OSC_IN: C8.1, U4.3 (PC14/OSC32_IN), Y1.1
/RTC_OSC_OUT: C9.1, U4.4 (PC15/OSC32_OUT), Y1.2
/SDMMC_CLK: J2.5 (CLK), U4.53 (PC12/SDCLK/SPI3_MOSI)
/SDMMC_CMD: J2.3 (CMD), U4.54 (PD2/SDCMD)
/SDMMC_D0: J2.7 (DAT0), U4.39 (PC8/SDD0)
/SDMMC_D1: J2.8 (DAT1), U4.40 (PC9/SDD1)
/SDMMC_D2: J2.1 (DAT2), U4.51 (PC10/SDD2/SPI3_SCK)
/SDMMC_D3: J2.2 (DAT3/CD), U4.52 (PC11/SDD3/SPI3_MISO)
/SDMMC_DET: J2.9 (DET), U4.2 (PC13)
/VBUS: F1.1, J1.1 (VBUS), P2.1, U2.5 (VBUS)
/VIN: C1.1, F1.2, U1.1 (IN), U1.3 (EN)
/~RST: U3.1 (~RST), U4.7 (NRST)
GND: C1.2, C2.2, C3.2, C4.2, C5.2, C6.2, C7.1, C8.2, C9.2, C10.2, C11.2, C12.2, C13.2, C14.2, C15.2, C16.2, C17.2, C18.2, J1.5 (GND), J2.6 (VSS), J2.10 (SHIELD), NT1.1, P3.3, P3.5, P3.9, P6.1, R2.1, R3.2, R4.2, SW2.1, U1.2 (GND), U2.2 (GND), U3.2 (GND), U4.18 (VSSUSB), U4.31 (VSS0), U4.47 (VSS1), U4.63 (VSS2), X1.2 (gnd)
unnamed: D1.1 (K), R3.1
unnamed: D2.1 (K), R4.1
VDD: C2.1, C3.1, C7.2, C10.1, C11.1, C12.1, C13.1, C14.1, C15.1, C16.1, C17.1, D2.2 (A), FB2.2, J2.4 (VDD), P1.1, P3.1, U1.5 (OUT), U3.5 (VCC), U4.1 (VBAT), U4.19 (VDD0), U4.32 (VDD1), U4.48 (VDDUSB), U4.64 (VDD2)
VDDA: C5.1, C6.1, FB2.1, U4.13 (VDDA/VREF+)
VSSA: NT1.2, U4.12 (VSSA/VREF-)

Notes on the sheet:
The APX823's manual reset line (~{MR}) has internal pullup of 60 kOhm.

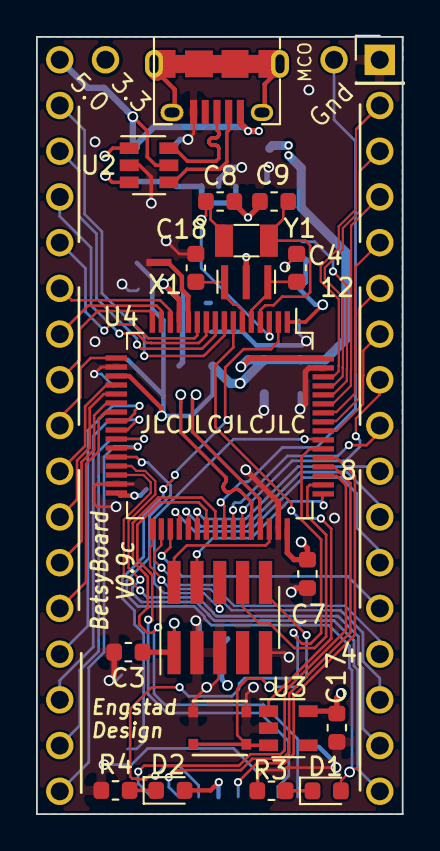
[picture p8: board BetsyBoard.kicad_pcb from above]

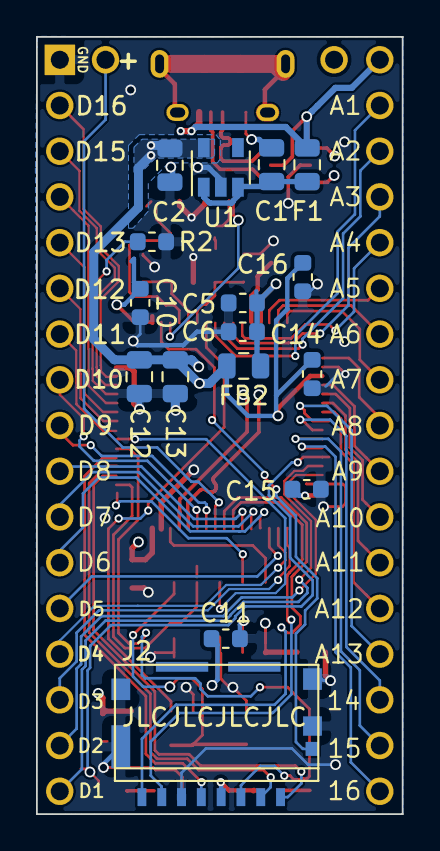
[picture p9: board BetsyBoard.kicad_pcb from below]

Board: 4 copper layers, 20.3 x 43.2 mm, 42 parts (18 on the bottom side), 64 nets.
