engstad/BetsyBoard/(commit log)

2015-09-28 Last changes
    [DipsyBoard.kicad_pcb, DipsyBoard.sch]
2015-10-09 Changes of power source
    [DipsyBoard.kicad_pcb, DipsyBoard.sch]
2015-10-09 push everything to repo
    [DipsyBoard-B_Cu.gbl, DipsyBoard-B_Mask.gbs, DipsyBoard-B_SilkS.gbo, DipsyBoard-Edge_Cuts.gm1, DipsyBoard-F_Cu.gtl, DipsyBoard-F_Mask.gts, DipsyBoard-F_SilkS.gto, DipsyBoard.drl]
2015-10-19 latest - including v0.1
    [DipsyBoard.kicad_pcb, DipsyBoard.sch, _saved_DipsyBoard.sch]
2015-11-03 v0.2 gerbers
    [DipsyBoard-B_Cu.gbr, DipsyBoard-B_Mask.gbr, DipsyBoard-B_SilkS.gbr, DipsyBoard-Edge_Cuts.gbr, DipsyBoard-F_Cu.gbr, DipsyBoard-F_Mask.gbr, DipsyBoard-F_SilkS.gbr, DipsyBoard-Margin.gbr]
2015-11-04 More work
    [DipsyBoard.kicad_pcb, DipsyBoard.sch]
2015-11-04 renaming Dipsy to Betsy
    [BetsyBoard-BreadBoard.kicad_pcb, BetsyBoard.kicad_pcb, BetsyBoard.sch]
2015-12-10 VBAT stuff
    [BetsyBoard.kicad_pcb, BetsyBoard.sch]
2015-12-16 Newest component
    [BetsyBoard.sch]
2015-12-21 Work towards v0.5
    [BetsyBoard.kicad_pcb, BetsyBoard.sch]
2015-12-22 Trying to fit DIP switch
    [BetsyBoard.kicad_pcb, BetsyBoard.sch]
2015-12-28 A little more work
    [BetsyBoard.kicad_pcb, BetsyBoard.sch]
2016-03-13 Move connection from NRST to /MR.
    [BetsyBoard.kicad_pcb, BetsyBoard.sch, fpc-board.kicad_pcb]
2016-08-25 Adding more pin numbers on silkscreen.
    [BetsyBoard.kicad_pcb, BetsyBoard.sch]
2017-05-08 small dabbles
    [BetsyBoard.kicad_pcb]
2017-05-08 apx comments
    [BetsyBoard.kicad_pcb, BetsyBoard.sch]
2020-09-21 Working towards 0.9.
    - Remove NJTRST and NRST confusion
    - Remove VBUS, not needed for upstream facing port.
    - Remove shielding, don't mess with the upstream ground.
    - Put back SDMMC, it's not the same as QSPI.
    - Add README.md.
    [BetsyBoard.kicad_pcb, BetsyBoard.sch]
2020-09-27 More changes
    [BetsyBoard.kicad_pcb, BetsyBoard.sch]
2020-09-27 Fix rescued symbols
    [BetsyBoard-BreadBoard.kicad_pcb, BetsyBoard.sch, fpc-board.kicad_pcb]
2020-09-28 Big version
    [BetsyBoardBig.kicad_pcb, BetsyBoardBig.sch]
2020-09-30 Changes to the BBB.
    - Fixing the QSPI_SCK problem.
    - Cleaning up.
    [BetsyBoardBig.kicad_pcb, BetsyBoardBig.sch]
2020-09-30 Add the first gerbers for BBB as it went to JLCPCB for order.
    [BetsyBoardBig-B_Cu.gbl, BetsyBoardBig-B_Mask.gbs, BetsyBoardBig-B_SilkS.gbo, BetsyBoardBig-Edge_Cuts.gm1, BetsyBoardBig-F_Cu.gtl, BetsyBoardBig-F_Mask.gts, BetsyBoardBig-F_Paste.gtp, BetsyBoardBig-F_SilkS.gto]
2020-10-09 Major changes due to mistakes
    [BetsyBoard.kicad_pcb, BetsyBoard.sch, BetsyBoardBig.kicad_pcb, BetsyBoardBig.sch]
2020-10-18 More changes.
    [BetsyBoardBig.kicad_pcb, BetsyBoardBig.sch]
2020-10-20 Adding +5V support for I2C port, and fixing courtyard layer.
    [BetsyBoardBig.kicad_pcb, BetsyBoardBig.sch]
2020-10-20 Use a battery header I can actually procure.
    [BetsyBoardBig.kicad_pcb, BetsyBoardBig.sch]
2020-10-23 Simplify a bit.
    [BetsyBoardBig.kicad_pcb, BetsyBoardBig.sch]
2020-11-02 Making more space.
    [BetsyBoardBig.sch]
2020-11-03 Fitting in bigger buttons and adding reset/boot circuit.
    [BetsyBoardBig.kicad_pcb, BetsyBoardBig.sch]
2021-04-19 Additions due to single-button boot logic.
    [BetsyBoardBig.kicad_pcb, BetsyBoardBig.sch]
2021-04-23 Prepare for second run.
    [BetsyBoardBig.kicad_pcb, BetsyBoardBig.sch]
2021-05-24 Use 4-pin QSPI NOR Flash card
    [BetsyBoardBig.kicad_pcb, BetsyBoardBig.sch]
2021-05-30 Version 0.9c of BetsyBoard
    [BetsyBoard-B_Cu.gbl, BetsyBoard-B_Mask.gbs, BetsyBoard-B_SilkS.gbo, BetsyBoard-Edge_Cuts.gm1, BetsyBoard-F_Cu.gtl, BetsyBoard-F_Mask.gts, BetsyBoard-F_SilkS.gto, BetsyBoard-Margin.gbr]
2021-05-30 Latest work on big version
    [BetsyBoardBig-B_Cu.gbl, BetsyBoardBig-B_Mask.gbs, BetsyBoardBig-B_SilkS.gbo, BetsyBoardBig-Edge_Cuts.gm1, BetsyBoardBig-F_Cu.gtl, BetsyBoardBig-F_Mask.gts, BetsyBoardBig-F_Paste.gtp, BetsyBoardBig-F_SilkS.gto]
2021-06-04 Getting ready for "final" big version.
    [BetsyBoardBig.kicad_pcb, BetsyBoardBig.sch]
2021-06-04 Thsi too.
    [BetsyBoardBig.sch]
2023-01-19 Save from old computer.
    [BetsyBoardBig.kicad_pcb, BetsyBoardBig.kicad_sch, BetsyBoardBig.sch]
2024-01-05 More work on battery charging.
    [BetsyBoard.kicad_pcb, BetsyBoard.kicad_sch, BetsyBoardBig.kicad_pcb, BetsyBoardBig.kicad_sch]
2024-01-12 v0.98 for production
    [bom.csv, designators.csv, positions.csv]
2024-01-12 Reworking reset pin on JTAG/SWD header and adding AND-gate.
    [BetsyBoardBig.kicad_pcb, BetsyBoardBig.kicad_sch]
